Thenicolaibulow/decaVox/decaVox.kicad_sch

## KiCad design decaVox.kicad_sch (2022-06-22)

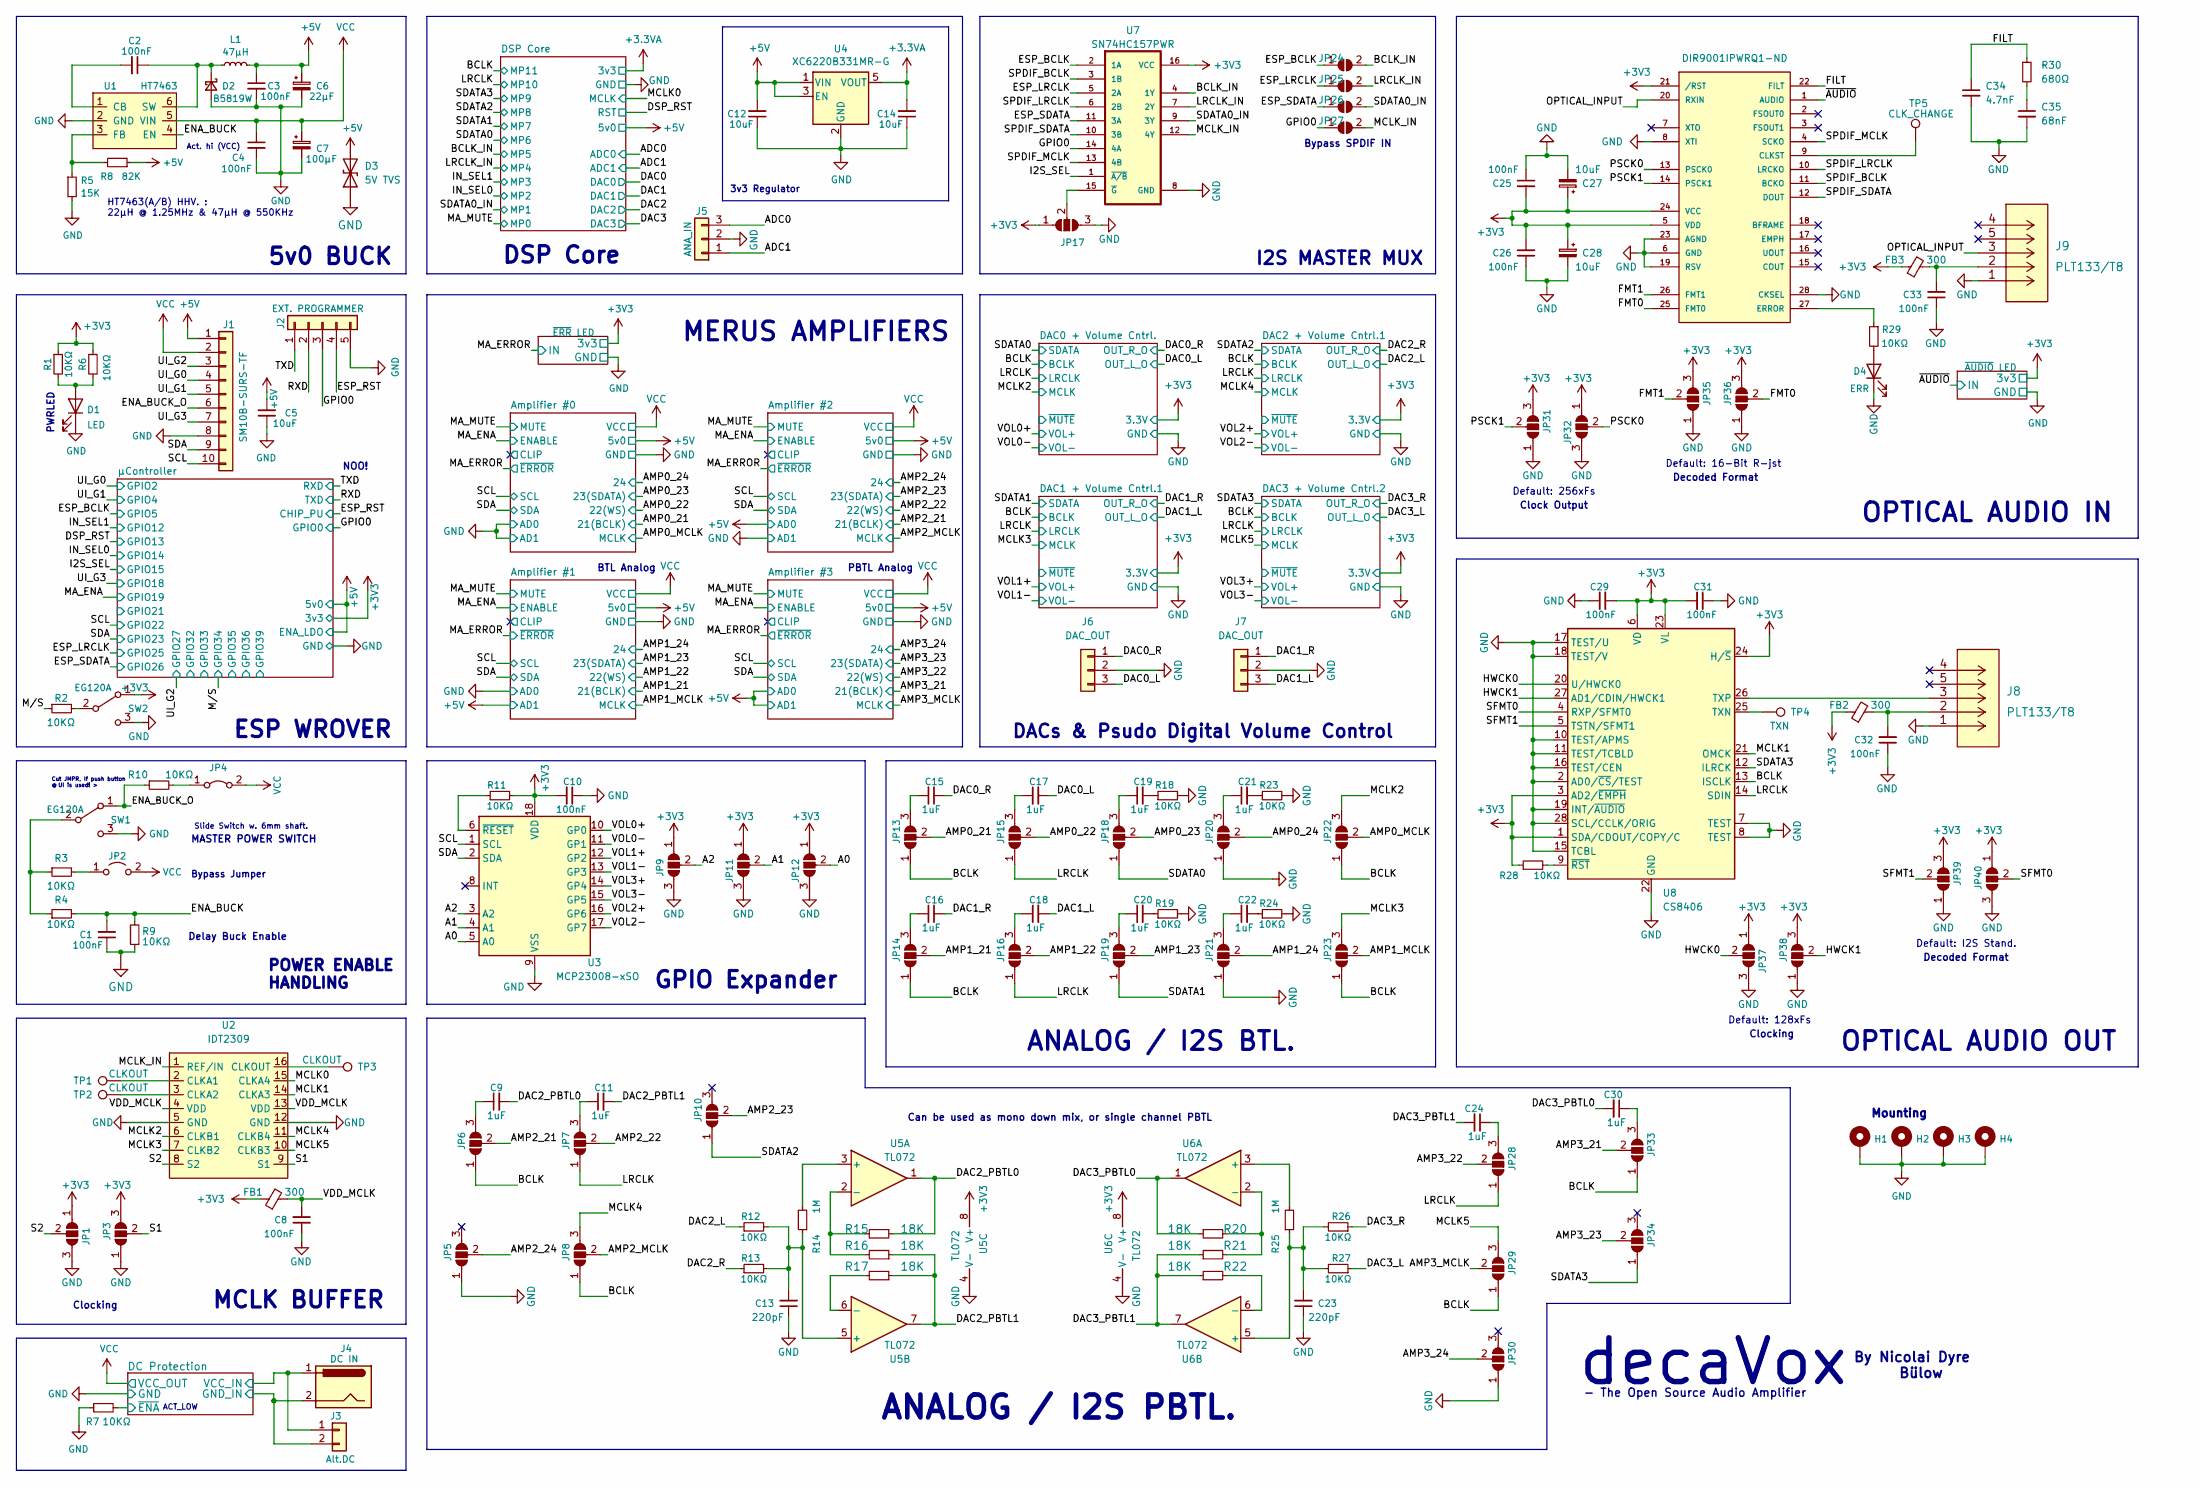
[picture p3: schematic decaVox.kicad_sch]

Parts:
C1, C2, C3, C4, C8, C10, C25, C26, C29, C31, C32, C33: 100nF; C_0603_1608Metric; LCSC C30926
C5: 10uF; C_0805_2012Metric; LCSC C162422
C6: 22µF; CP_Elec_4x5.4; LCSC C87865
C7: 100µF; CP_Elec_8x10; LCSC C38513
C9, C11, C15, C16, C17, C18, C19, C20, C21, C22, C24, C30: C_0603_1608Metric; LCSC C157684
C12, C14: 10uF; C_0603_1608Metric; LCSC C326057
C13, C23: C_0603_1608Metric; LCSC C302062
C27, C28: 10uF; CP_Elec_4x5.4; LCSC C213487
C34: 4.7nF; C_0603_1608Metric; LCSC C77057
C35: 68nF; C_0603_1608Metric; LCSC C354392
D1: LED; D_0603_1608Metric; LCSC C264445
D2: B5819W; D_SOD-123; LCSC C64885
D3: 5V TVS; D_SOD-323; LCSC C511254
D4: ERR; LED_0603_1608Metric; Digikey 160-1445-1-ND
FB1, FB2, FB3: 300; L_0603_1608Metric; LCSC C304316
H1, H2, H3, H4: MountingHole_Pad; MountingHole_3.2mm_M3_DIN965_Pad
J1: SM10B-SURS-TF; JST_SUR_SM10B-SURS-TF_1x10-1MP_P0.80mm_Horizontal; Digikey 455-2041-1-ND
J2: EXT. PROGRAMMER; PinHeader_1x05_P2.54mm_Vertical; LCSC C124379
J3: Alt.DC; JST_VH_B2PS-VH_1x02_P3.96mm_Horizontal
J4: DC IN; BarrelJack_CUI_PJ-063AH_Horizontal; Digikey CP-063AH-ND
J5: ANA_IN; PinHeader_1x03_P2.54mm_Vertical
J6, J7: DAC_OUT; PinHeader_1x03_P2.54mm_Vertical
J8, J9: PLT133/T8; PLT133&slash_T8; Digikey 1080-1505-ND
JP1, JP3, JP5, JP6, JP7, JP8, JP9, JP10, JP11, JP12, JP13, JP14, JP15, JP16, JP18, JP19, JP20, JP21, JP22, JP23, JP28, JP29, JP30, JP31, JP32, JP33, JP34, JP35, JP36, JP37, JP38, JP39, JP40: SolderJumper-3_P1.3mm_Bridged12_RoundedPad1.0x1.5mm
JP2: Jumper_2_Open; SolderJumper-2_P1.3mm_Open_RoundedPad1.0x1.5mm
JP4: Jumper_2_Bridged; SolderJumper-2_P1.3mm_Bridged_RoundedPad1.0x1.5mm
JP17: SolderJumper-3_P1.3mm_Open_RoundedPad1.0x1.5mm
JP24, JP25, JP26, JP27: SolderJumper_2_Open; SolderJumper-2_P1.3mm_Open_RoundedPad1.0x1.5mm
L1: 47µH; L_10.4x10.4_H4.8; LCSC C216171
R1, R2, R3, R4, R6, R7, R9, R10, R11, R12, R13, R18, R19, R23, R24, R26, R27, R28, R29: 10KΩ; R_0603_1608Metric; LCSC C98220
R5: 15K; R_0603_1608Metric; LCSC C328339
R8: 82K; R_0603_1608Metric; LCSC C23254
R14, R25: 1M; R_0603_1608Metric; LCSC C107698
R15, R16, R17, R20, R21, R22: 470O_08050805_R; R_0603_1608Metric; MFT_PART RTT05101JTP; LCSC C218379
R30: 680Ω; R_0603_1608Metric; LCSC C328372
SW1, SW2: EG120A; SLIDE-SWITCH; Digikey EG1917-ND
TP1, TP2, TP3: CLKOUT; TestPoint_Pad_D1.5mm
TP4: TXN; TestPoint_Pad_D1.5mm
TP5: CLK_CHANGE; TestPoint_Pad_D1.5mm
U1: HT7463; SOT-23-6; LCSC C95080
U2: IDT2309; SOIC-16_3.9x9.9mm_P1.27mm; Digikey 800-3296-5-ND
U3: MCP23008-xSO; SOIC-18W_7.5x11.6mm_P1.27mm
U4: XC6220B331MR-G; SOT-23-5; Digikey 893-1133-1-ND
U5: TL072; SO-8_3.9x4.9mm_P1.27mm
U6: TL072; SO-8_3.9x4.9mm_P1.27mm; Digikey 497-2200-1-ND
U7: SN74HC157PWR; TSSOP-16_4.4x5mm_P0.65mm; Digikey 296-29862-1-ND
U8: CS8406; TSSOP-28_4.4x9.7mm_P0.65mm; LCSC C11162
U9: DIR9001-Q1; TSSOP-28_4.4x9.7mm_P0.65mm; Digikey DIR9001IPWRQ1-ND

Connections:
+3.3VA: C14.2, U4.5 (VOUT)
+3V3: C10.2, C25.2, C26.2, C27.1, C28.1, C29.2, C31.2, FB1.1, FB2.1, FB3.1, JP1.1 (A), JP3.3 (B), JP9.1 (A), JP11.1 (A), JP12.1 (A), JP17.1 (A), JP31.3 (B), JP32.1 (A), JP35.3 (B), JP36.3 (B), JP37.1 (A), JP38.3 (B), JP39.3 (B), JP40.1 (A), R1.1, R6.1, R11.2, R28.1, SW2.1 (A), U3.18 (VDD), U5.8 (V+), U6.8 (V+), U7.16 (VCC), U8.1 (SDA/CDOUT/COPY/C), U8.3 (AD2/~EMPH), U8.6 (VD), U8.23 (VL), U8.24 (H/~S), U9.5 (VDD), U9.21 (/RST), U9.24 (VCC)
+5V: C3.1, C5.2, C6.1, C12.2, D3.2 (A2), J1.1, L1.2, R8.1, U4.1 (VIN), U4.3 (EN)
A0: JP12.2 (C), U3.5 (A0)
A1: JP11.2 (C), U3.4 (A1)
A2: JP9.2 (C), U3.3 (A2)
ADC0: J5.3
ADC1: J5.1
AMP0_21: JP13.2 (C)
AMP0_22: JP15.2 (C)
AMP0_23: JP18.2 (C)
AMP0_24: JP20.2 (C)
AMP0_MCLK: JP22.2 (C)
AMP1_21: JP14.2 (C)
AMP1_22: JP16.2 (C)
AMP1_23: JP19.2 (C)
AMP1_24: JP21.2 (C)
AMP1_MCLK: JP23.2 (C)
AMP2_21: JP6.2 (C)
AMP2_22: JP7.2 (C)
AMP2_23: JP10.2 (C)
AMP2_24: JP5.2 (C)
AMP2_MCLK: JP8.2 (C)
AMP3_21: JP33.2 (C)
AMP3_22: JP28.2 (C)
AMP3_23: JP34.2 (C)
AMP3_24: JP30.2 (C)
AMP3_MCLK: JP29.2 (C)
BCLK: JP6.1 (A), JP8.1 (A), JP13.1 (A), JP14.1 (A), JP22.1 (A), JP23.1 (A), JP29.1 (A), JP33.1 (A), U8.13 (ISCLK)
BCLK_IN: JP24.2 (B), U7.4 (1Y)
DAC0_L: C17.2, J6.3
DAC0_R: C15.2, J6.1
DAC1_L: C18.2, J7.3
DAC1_R: C16.2, J7.1
DAC2_L: R12.1
DAC2_PBTL0: C9.2, R15.1, U5.1
DAC2_PBTL1: C11.2, R16.1, R17.1, U5.7
DAC2_R: R13.1
DAC3_L: R27.1
DAC3_PBTL0: C30.2, R20.1, U6.1
DAC3_PBTL1: C24.2, R21.1, R22.1, U6.7
DAC3_R: R26.1
ENA_BUCK: C1.2, R4.2, R9.2, U1.4 (EN)
ENA_BUCK_O: J1.6, R10.1, SW1.1 (A)
ESP_BCLK: JP24.1 (A), U7.2 (1A)
ESP_LRCLK: JP25.1 (A), U7.5 (2A)
ESP_RST: J2.4
ESP_SDATA: JP26.1 (A), U7.11 (3A)
FILT: C34.1, R30.1, U9.22 (FILT)
FMT0: JP36.2 (C), U9.25 (FMT0)
FMT1: JP35.2 (C), U9.26 (FMT1)
GND: C1.1, C3.2, C4.2, C5.1, C6.2, C7.2, C8.1, C10.1, C12.1, C13.1, C14.1, C23.1, C25.1, C26.1, C27.2, C28.2, C29.1, C31.1, C32.1, C33.1, C34.2, C35.2, D1.1 (K), D2.2 (A), D3.1 (A1), D4.1 (K), H1.1, H2.1, H3.1, H4.1, J1.8, J2.5, J5.2, J6.2, J7.2, J8.1, J9.1, JP1.3 (B), JP3.1 (A), JP5.1 (A), JP9.3 (B), JP11.3 (B), JP12.3 (B), JP17.3 (B), JP20.1 (A), JP21.1 (A), JP30.1 (A), JP31.1 (A), JP32.3 (B), JP35.1 (A), JP36.1 (A), JP37.3 (B), JP38.1 (A), JP39.1 (A), JP40.3 (B), R5.2, R7.1, R9.1, R18.2, R19.2, R23.2, R24.2, SW1.3 (C), SW2.3 (C), U1.2 (GND), U2.5 (GND), U2.12 (GND), U3.9 (VSS), U4.2 (GND), U5.4 (V-), U6.4 (V-), U7.8 (GND), U8.2 (AD0/~CS/TEST), U8.7 (TEST), U8.8 (TEST), U8.10 (TEST/APMS), U8.11 (TEST/TCBLD), U8.15 (TCBL), U8.16 (TEST/CEN), U8.17 (TEST/U), U8.18 (TEST/V), U8.19 (INT/~AUDIO), U8.22 (GND), U8.28 (SCL/CCLK/ORIG), U9.6 (GND), U9.8 (XTI), U9.19 (RSV), U9.23 (AGND), U9.28 (CKSEL)
GND_IN: J3.2, J4.2
GPIO0: J2.3, JP27.1 (A), U7.14 (4A)
HWCK0: JP37.2 (C), U8.20 (U/HWCK0)
HWCK1: JP38.2 (C), U8.27 (AD1/CDIN/HWCK1)
I2S_SEL: U7.1 (~A/B)
LRCLK: JP7.1 (A), JP15.1 (A), JP16.1 (A), JP28.1 (A), U8.14 (SDIN)
LRCLK_IN: JP25.2 (B), U7.7 (2Y)
MCLK0: U2.15 (CLKA4)
MCLK1: U2.14 (CLKA3), U8.21 (OMCK)
MCLK2: JP22.3 (B), U2.6 (CLKB1)
MCLK3: JP23.3 (B), U2.7 (CLKB2)
MCLK4: JP8.3 (B), U2.11 (CLKB4)
MCLK5: JP29.3 (B), U2.10 (CLKB3)
MCLK_IN: JP27.2 (B), U2.1 (REF/IN), U7.12 (4Y)
M/S: R2.1
unnamed: C2.1, D2.1 (K), L1.1, U1.6 (SW)
unnamed: C2.2, U1.1 (CB)
unnamed: C9.1, JP6.3 (B)
unnamed: C11.1, JP7.3 (B)
unnamed: C13.2, R12.2, R13.2, R14.1, U5.5 (+)
unnamed: C15.1, JP13.3 (B)
unnamed: C16.1, JP14.3 (B)
unnamed: C17.1, JP15.3 (B)
unnamed: C18.1, JP16.3 (B)
unnamed: C19.1, JP18.3 (B)
unnamed: C19.2, R18.1
unnamed: C20.1, JP19.3 (B)
unnamed: C20.2, R19.1
unnamed: C21.1, JP20.3 (B)
unnamed: C21.2, R23.1
unnamed: C22.1, JP21.3 (B)
unnamed: C22.2, R24.1
unnamed: C23.2, R25.1, R26.2, R27.2, U6.5 (+)
unnamed: C24.1, JP28.3 (B)
unnamed: C30.1, JP33.3 (B)
unnamed: C32.2, FB2.2, J8.2
unnamed: C33.2, FB3.2, J9.2
unnamed: C35.1, R30.2
unnamed: D1.2 (A), R1.2, R6.2
unnamed: D4.2 (A), R29.2
unnamed: J8.3, U8.26 (TXP)
unnamed: JP2.1 (A), R3.2
unnamed: JP4.1 (A), R10.2
unnamed: JP17.2 (C), U7.15 (~G)
unnamed: R2.2, SW2.2 (B)
unnamed: R3.1, R4.1, SW1.2 (B)
unnamed: R5.1, R8.2, U1.3 (FB)
unnamed: R11.1, U3.6 (~RESET)
unnamed: R14.2, U5.3 (+)
unnamed: R15.2, R16.2, U5.2 (-)
unnamed: R17.2, U5.6 (-)
unnamed: R20.2, R21.2, U6.2 (-)
unnamed: R22.2, U6.6 (-)
unnamed: R25.2, U6.3 (+)
unnamed: R28.2, U8.9 (~RST)
unnamed: R29.1, U9.27 (ERROR)
unnamed: TP1.1, U2.2 (CLKA1)
unnamed: TP2.1, U2.3 (CLKA2)
unnamed: TP3.1, U2.16 (CLKOUT)
unnamed: TP4.1, U8.25 (TXN)
unnamed: TP5.1, U9.9 (CLKST)
OPTICAL_INPUT: J9.3, U9.20 (RXIN)
PSCK0: JP32.2 (C), U9.13 (PSCK0)
PSCK1: JP31.2 (C), U9.14 (PSCK1)
RXD: J2.2
S1: JP3.2 (C), U2.9 (S1)
S2: JP1.2 (C), U2.8 (S2)
SCL: J1.10, U3.1 (SCL)
SDA: J1.9, U3.2 (SDA)
SDATA0: JP18.1 (A)
SDATA0_IN: JP26.2 (B), U7.9 (3Y)
SDATA1: JP19.1 (A)
SDATA2: JP10.1 (A)
SDATA3: JP34.1 (A), U8.12 (ILRCK)
SFMT0: JP40.2 (C), U8.4 (RXP/SFMT0)
SFMT1: JP39.2 (C), U8.5 (TSTN/SFMT1)
SPDIF_BCLK: U7.3 (1B), U9.11 (BCKO)
SPDIF_LRCLK: U7.6 (2B), U9.10 (LRCKO)
SPDIF_MCLK: U7.13 (4B), U9.4 (SCKO)
SPDIF_SDATA: U7.10 (3B), U9.12 (DOUT)
TXD: J2.1
UI_G0: J1.4
UI_G1: J1.5
UI_G2: J1.3
UI_G3: J1.7
VCC: C4.1, C7.1, J1.2, JP2.2 (B), JP4.2 (B), U1.5 (VIN)
VCC_IN: J3.1, J4.1
VDD_MCLK: C8.2, FB1.2, U2.4 (VDD), U2.13 (VDD)
VOL0+: U3.10 (GP0)
VOL0-: U3.11 (GP1)
VOL1+: U3.12 (GP2)
VOL1-: U3.13 (GP3)
VOL2+: U3.16 (GP6)
VOL2-: U3.17 (GP7)
VOL3+: U3.14 (GP4)
VOL3-: U3.15 (GP5)
~AUDIO: U9.1 (AUDIO)
~ENA: R7.2

Notes on the sheet:
Bypass Jumper
Clocking
PBTL Analog
5v0 BUCK
PWRLED
ANALOG / I2S BTL.
POWER ENABLE HANDLING
Delay Buck Enable
DACs & Psudo Digital Volume Control
Cut JMPR, If push button @ UI is used! >
HT7463(A/B) HHV. : 22µH @ 1.25MHz & 47µH @ 550KHz
ESP WROVER
ANALOG / I2S PBTL.
Default: 128xFs
MCLK BUFFER
3v3 Regulator
Default: I2S Stand.
OPTICAL AUDIO IN
BTL Analog
Decoded Format
Act. hi (VCC)
I2S MASTER MUX
Default: 16-Bit R-jst
- The Open Source Audio Amplifier
MASTER POWER SWITCH
Mounting
decaVox
NOO!
ACT_LOW
Can be used as mono down mix, or single channel PBTL
By Nicolai Dyre Bülow
Default: 256xFs
Clock Output
GPIO Expander
Bypass SPDIF IN
OPTICAL AUDIO OUT
Slide Switch w. 6mm shaft.
DSP Core
MERUS AMPLIFIERS
