Thenicolaibulow/decaVox/Ext_Sch/ADAU1701.kicad_sch

## KiCad design Ext_Sch/ADAU1701.kicad_sch (2022-06-22)

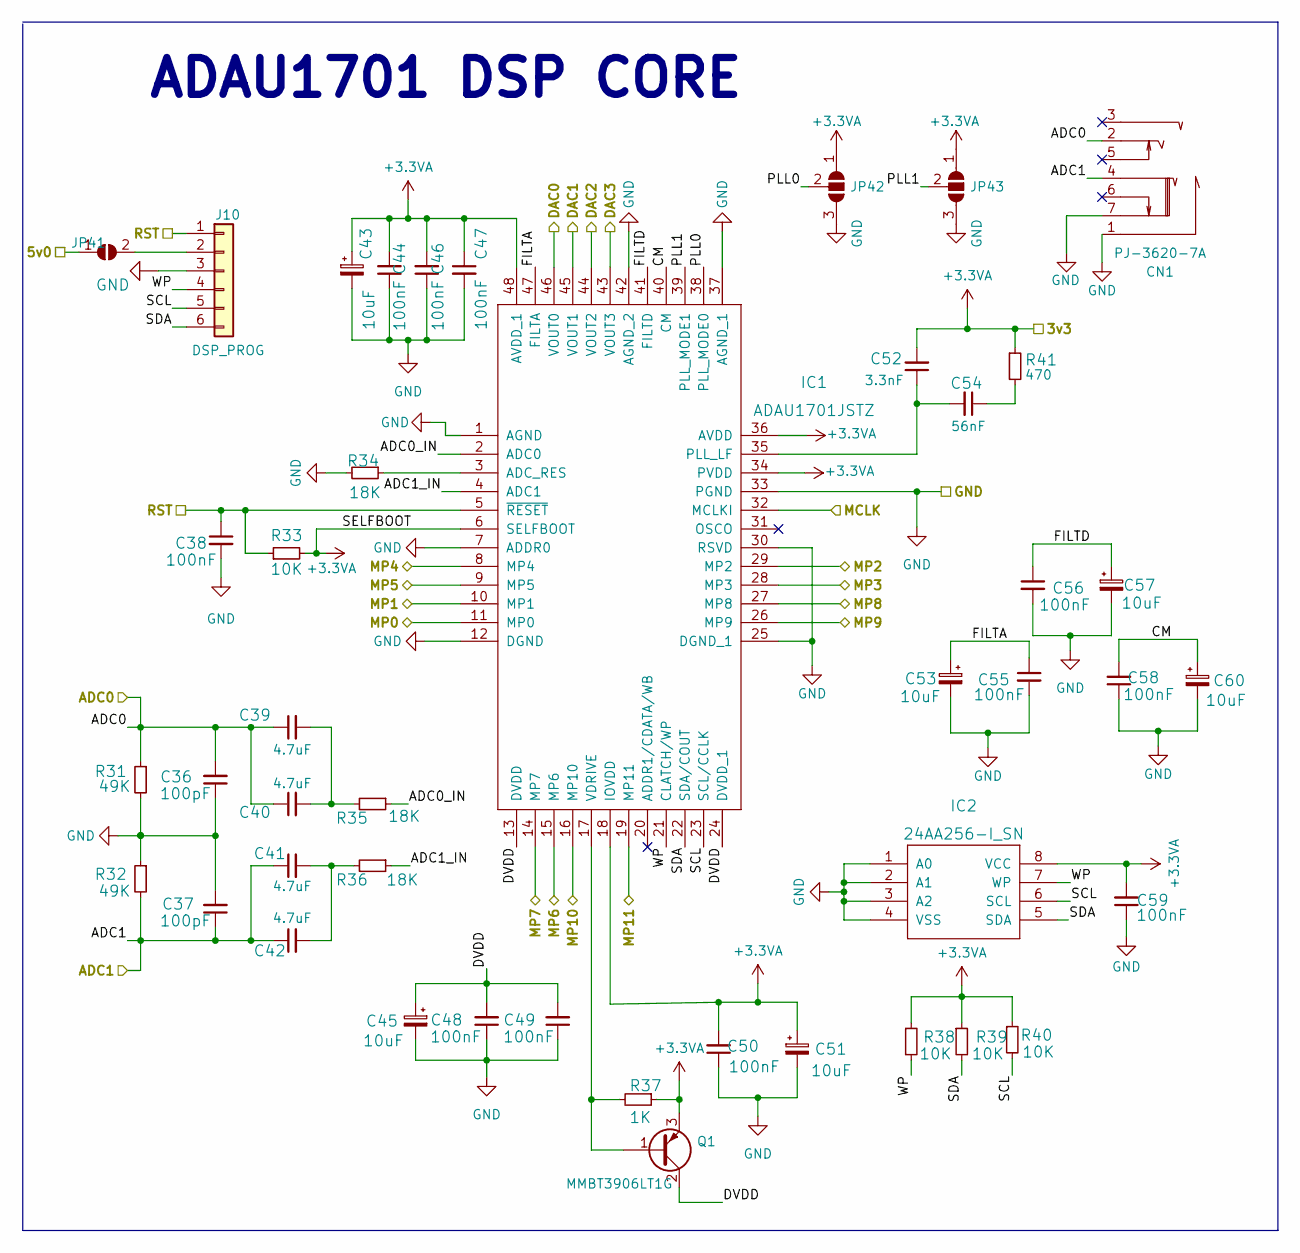
[picture p4: schematic ADAU1701.kicad_sch]

Parts:
C36, C37: 100NF_SMD_0805; C_0603_1608Metric; LCSC C82028
C38: 100NF_SMD_0805; C_0603_1608Metric; LCSC C128353
C39, C40, C41, C42: 4.7UF_CAP_SMD_06030603C; C_0603_1608Metric; LCSC C8032
C43, C45, C51, C53, C57, C60: TAJR106K006RNJ; CP_EIA-2012-12_Kemet-R; LCSC C132274
C44, C46, C47, C48, C49, C50, C55, C56, C58, C59: 100NF_SMD_0805; C_0603_1608Metric; LCSC C83054
C52: 3.3NF_CAP_SMD_08050805; C_0603_1608Metric; LCSC C92203
C54: 56NF_CAP_SMD_08050805; C_0603_1608Metric; LCSC C1780
CN1: PJ-3620-7A; AUDIO-TH_PJ-3620-7A; LCSC C879479
IC1: ADAU1701JSTZ; LQFP-48_7x7mm_P0.5mm
IC2: 24AA256-I_SN; SOIC-8_3.9x4.9mm_P1.27mm
J10: DSP_PROG; PinHeader_1x06_P2.54mm_Vertical
JP41: SolderJumper_2_Open; SolderJumper-2_P1.3mm_Open_RoundedPad1.0x1.5mm
JP42, JP43: SolderJumper_3_Open; SolderJumper-3_P1.3mm_Open_RoundedPad1.0x1.5mm
Q1: MMBT3906LT1G; SOT-23; LCSC C53444
R31, R32: 470O_08050805_R; R_0603_1608Metric; MFT_PART RTT05101JTP; LCSC C218595
R33, R38, R39, R40: 470O_08050805_R; R_0603_1608Metric; MFT_PART RTT05101JTP; LCSC C25612
R34, R35, R36: 470O_08050805_R; R_0603_1608Metric; MFT_PART RTT05101JTP; LCSC C218379
R37: 1K_0603; R_0603_1608Metric; LCSC C14676
R41: 470; R_0603_1608Metric; LCSC C114564

Connections:
5v0: JP41.1 (A)
+3.3VA: C43.1, C44.2, C46.2, C47.1, C50.2, C51.1, C52.2, C59.2, IC1.6 (SELFBOOT), IC1.18 (IOVDD), IC1.34 (PVDD), IC1.36 (AVDD), IC1.48 (AVDD_1), IC2.8 (VCC), JP42.1 (A), JP43.1 (A), Q1.3 (E), R33.2, R37.1, R38.1, R39.1, R40.1, R41.1
ADC0: C36.2, C39.1, C40.1, CN1.2, R31.1
ADC0_IN: IC1.2 (ADC0), R35.1
ADC1: C37.1, C41.1, C42.1, CN1.4, R32.2
ADC1_IN: IC1.4 (ADC1), R36.1
CM: C58.2, C60.1, IC1.40 (CM)
DAC0: IC1.46 (VOUT0)
DAC1: IC1.45 (VOUT1)
DAC2: IC1.44 (VOUT2)
DAC3: IC1.43 (VOUT3)
DVDD: C45.1, C48.2, C49.2, IC1.13 (DVDD), IC1.24 (DVDD_1), Q1.2 (C)
FILTA: C53.1, C55.1, IC1.47 (FILTA)
FILTD: C56.1, C57.1, IC1.41 (FILTD)
GND: C36.1, C37.2, C38.2, C43.2, C44.1, C45.2, C46.1, C47.2, C48.1, C49.1, C50.1, C51.2, C53.2, C55.2, C56.2, C57.2, C58.1, C59.1, C60.2, CN1.1, CN1.7, IC1.1 (AGND), IC1.7 (ADDR0), IC1.12 (DGND), IC1.25 (DGND_1), IC1.30 (RSVD), IC1.33 (PGND), IC1.37 (AGND_1), IC1.42 (AGND_2), IC2.1 (A0), IC2.2 (A1), IC2.3 (A2), IC2.4 (VSS), J10.3, JP42.3 (B), JP43.3 (B), R31.2, R32.1, R34.2
MCLK: IC1.32 (MCLKI)
MP0: IC1.11 (MP0)
MP1: IC1.10 (MP1)
MP2: IC1.29 (MP2)
MP3: IC1.28 (MP3)
MP4: IC1.8 (MP4)
MP5: IC1.9 (MP5)
MP6: IC1.15 (MP6)
MP7: IC1.14 (MP7)
MP8: IC1.27 (MP8)
MP9: IC1.26 (MP9)
MP10: IC1.16 (MP10)
MP11: IC1.19 (MP11)
unnamed: C39.2, C40.2, R35.2
unnamed: C41.2, C42.2, R36.2
unnamed: C52.1, C54.2, IC1.35 (PLL_LF)
unnamed: C54.1, R41.2
unnamed: IC1.3 (ADC_RES), R34.1
unnamed: IC1.17 (VDRIVE), Q1.1 (B), R37.2
unnamed: J10.2, JP41.2 (B)
PLL0: IC1.38 (PLL_MODE0), JP42.2 (C)
PLL1: IC1.39 (PLL_MODE1), JP43.2 (C)
RST: C38.1, IC1.5 (~RESET), J10.1, R33.1
SCL: IC1.23 (SCL/CCLK), IC2.6 (SCL), J10.5, R40.2
SDA: IC1.22 (SDA/COUT), IC2.5 (SDA), J10.6, R39.2
WP: IC1.21 (CLATCH/WP), IC2.7 (WP), J10.4, R38.2

Notes on the sheet:
ADAU1701 DSP CORE
