Thenicolaibulow/decaVox/Ext_Sch/DAC+Digipot.kicad_sch

## KiCad design Ext_Sch/DAC+Digipot.kicad_sch (2022-06-22)

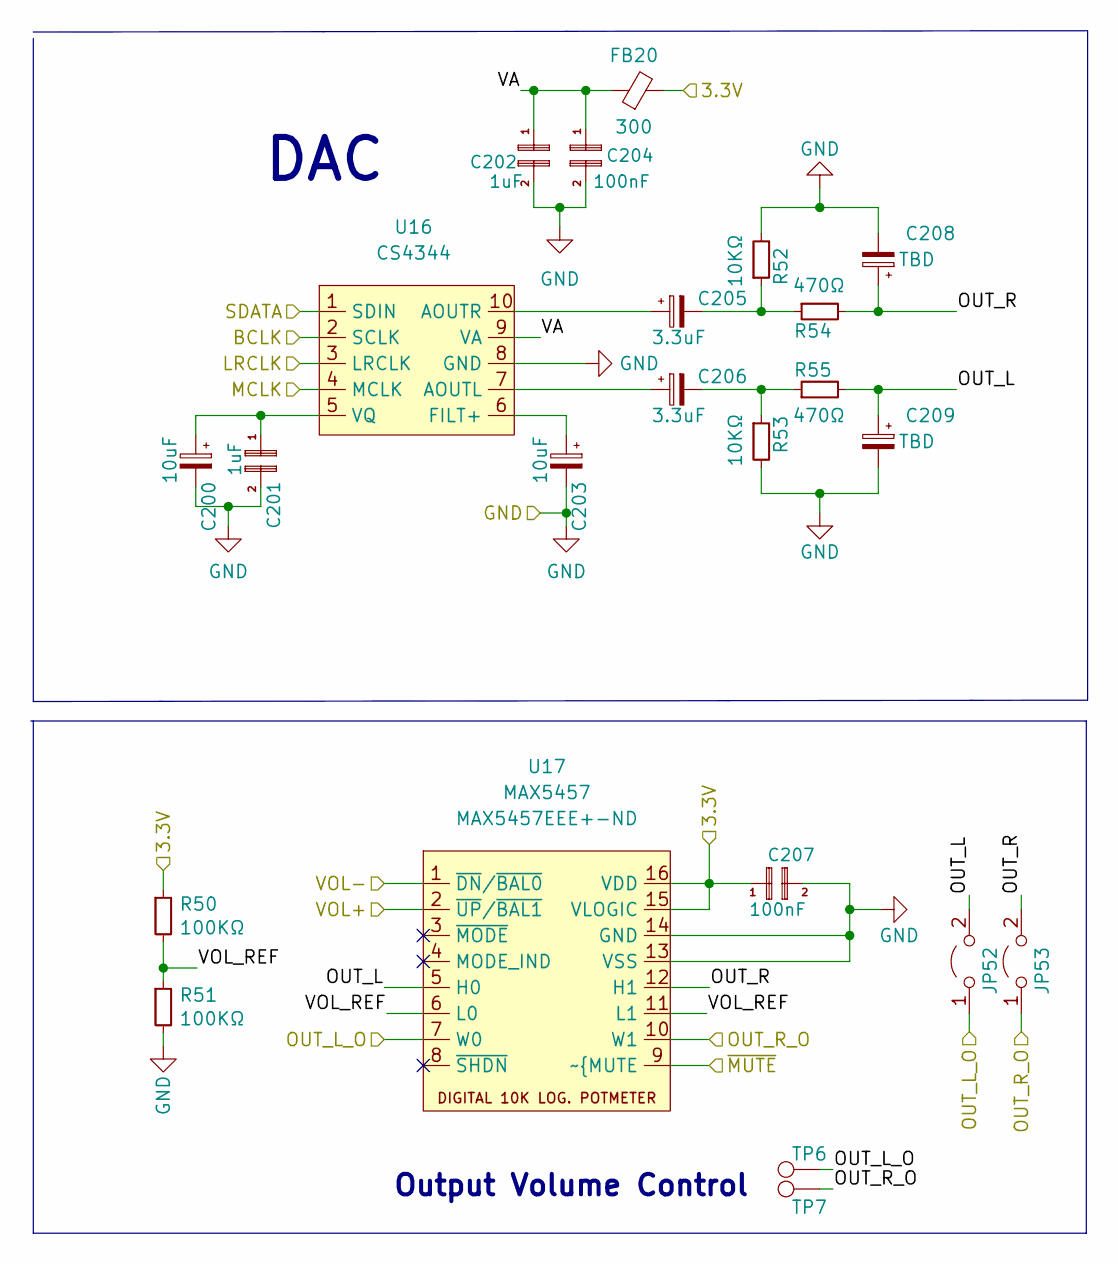
[picture p5: schematic DAC+Digipot.kicad_sch]

Parts:
C200, C203: 10uF; CP_Elec_4x5.4; LCSC C213487
C201, C202: 1uF; C_0603_1608Metric; LCSC C29936
C204, C207: 100nF; C_0603_1608Metric; LCSC C30926
C205, C206: 3.3uF; CP_Elec_3x5.3; LCSC C249528
C208, C209: TBD; CP_Elec_3x5.3
FB20: 300; L_0603_1608Metric; LCSC C304316
JP52, JP53: Jumper_2_Open; SolderJumper-2_P1.3mm_Open_RoundedPad1.0x1.5mm
R50, R51: 100KΩ; R_0603_1608Metric; LCSC C25803
R52, R53: 10KΩ; R_0603_1608Metric; LCSC C98220
R54, R55: 470Ω; R_0603_1608Metric; LCSC C269439
TP6, TP7: TestPoint; TestPoint_Pad_D1.5mm
U16: CS4344; TSSOP-10_3x3mm_P0.5mm; LCSC C8952
U17: MAX5457; SOP63P602X175-16N; Digikey MAX5457EEE+-ND

Connections:
3.3V: C207.1, FB20.2, R50.1, U17.15 (VLOGIC), U17.16 (VDD)
BCLK: U16.2 (SCLK)
GND: C200.2, C201.2, C202.2, C203.2, C204.2, C207.2, C208.2, C209.2, R51.2, R52.2, R53.2, U16.8 (GND), U17.13 (VSS), U17.14 (GND)
LRCLK: U16.3 (LRCLK)
MCLK: U16.4 (MCLK)
unnamed: C200.1, C201.1, U16.5 (VQ)
unnamed: C203.1, U16.6 (FILT+)
unnamed: C205.1, U16.10 (AOUTR)
unnamed: C205.2, R52.1, R54.1
unnamed: C206.1, U16.7 (AOUTL)
unnamed: C206.2, R53.1, R55.1
OUT_L: C209.1, JP52.2 (B), R55.2, U17.5 (H0)
OUT_L_O: JP52.1 (A), TP6.1, U17.7 (W0)
OUT_R: C208.1, JP53.2 (B), R54.2, U17.12 (H1)
OUT_R_O: JP53.1 (A), TP7.1, U17.10 (W1)
SDATA: U16.1 (SDIN)
VA: C202.1, C204.1, FB20.1, U16.9 (VA)
VOL+: U17.2 (~UP/~BAL1)
VOL-: U17.1 (~DN/~BAL0)
VOL_REF: R50.2, R51.1, U17.6 (L0), U17.11 (L1)
~MUTE: U17.9 (~{MUTE)

Notes on the sheet:
DAC
Output Volume Control
