Thenicolaibulow/decaVox/Ext_Sch/ESP32WROVER.kicad_sch

## KiCad design Ext_Sch/ESP32WROVER.kicad_sch (2022-06-22)

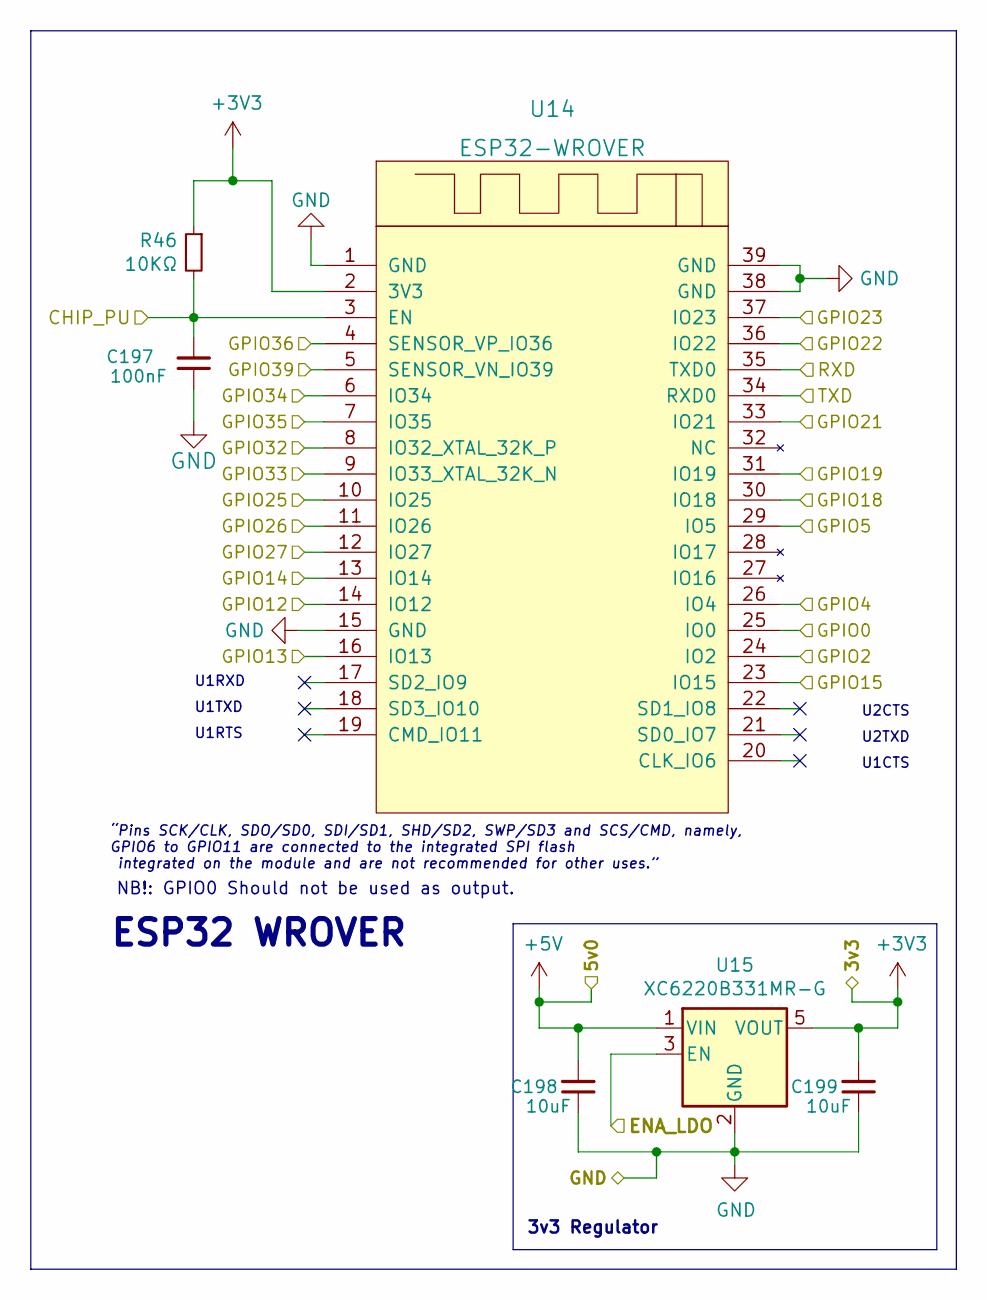
[picture p6: schematic ESP32WROVER.kicad_sch]

Parts:
C197: 100nF; C_0603_1608Metric; LCSC C30926
C198, C199: 10uF; C_0603_1608Metric; LCSC C326057
R46: 10KΩ; R_0603_1608Metric; LCSC C98220
U14: ESP32-WROVER; Digikey 1965-ESP32-WROVER-E-N16R8CT-ND
U15: XC6220B331MR-G; SOT-23-5; Digikey 893-1133-1-ND

Connections:
+3V3: C199.2, R46.1, U14.2 (3V3), U15.5 (VOUT)
+5V: C198.2, U15.1 (VIN)
CHIP_PU: C197.2, R46.2, U14.3 (EN)
ENA_LDO: U15.3 (EN)
GND: C197.1, C198.1, C199.1, U14.1 (GND), U14.15 (GND), U14.38 (GND), U14.39 (GND), U15.2 (GND)
GPIO0: U14.25 (IO0)
GPIO2: U14.24 (IO2)
GPIO4: U14.26 (IO4)
GPIO5: U14.29 (IO5)
GPIO12: U14.14 (IO12)
GPIO13: U14.16 (IO13)
GPIO14: U14.13 (IO14)
GPIO15: U14.23 (IO15)
GPIO18: U14.30 (IO18)
GPIO19: U14.31 (IO19)
GPIO21: U14.33 (IO21)
GPIO22: U14.36 (IO22)
GPIO23: U14.37 (IO23)
GPIO25: U14.10 (IO25)
GPIO26: U14.11 (IO26)
GPIO27: U14.12 (IO27)
GPIO32: U14.8 (IO32_XTAL_32K_P)
GPIO33: U14.9 (IO33_XTAL_32K_N)
GPIO34: U14.6 (IO34)
GPIO35: U14.7 (IO35)
GPIO36: U14.4 (SENSOR_VP_IO36)
GPIO39: U14.5 (SENSOR_VN_IO39)
RXD: U14.35 (TXD0)
TXD: U14.34 (RXD0)

Notes on the sheet:
U1RTS
U1TXD
3v3 Regulator
“Pins SCK/CLK, SDO/SD0, SDI/SD1, SHD/SD2, SWP/SD3 and SCS/CMD, namely, GPIO6 to GPIO11 are connected to the integrated SPI flash integrated on the module and are not recommended for other uses.”
U1CTS
U2CTS
NB!: GPIO0 Should not be used as output.
ESP32 WROVER
U2TXD
U1RXD
