Thenicolaibulow/decaVox/Ext_Sch/MA12070P.kicad_sch

## KiCad design Ext_Sch/MA12070P.kicad_sch (2022-06-22)

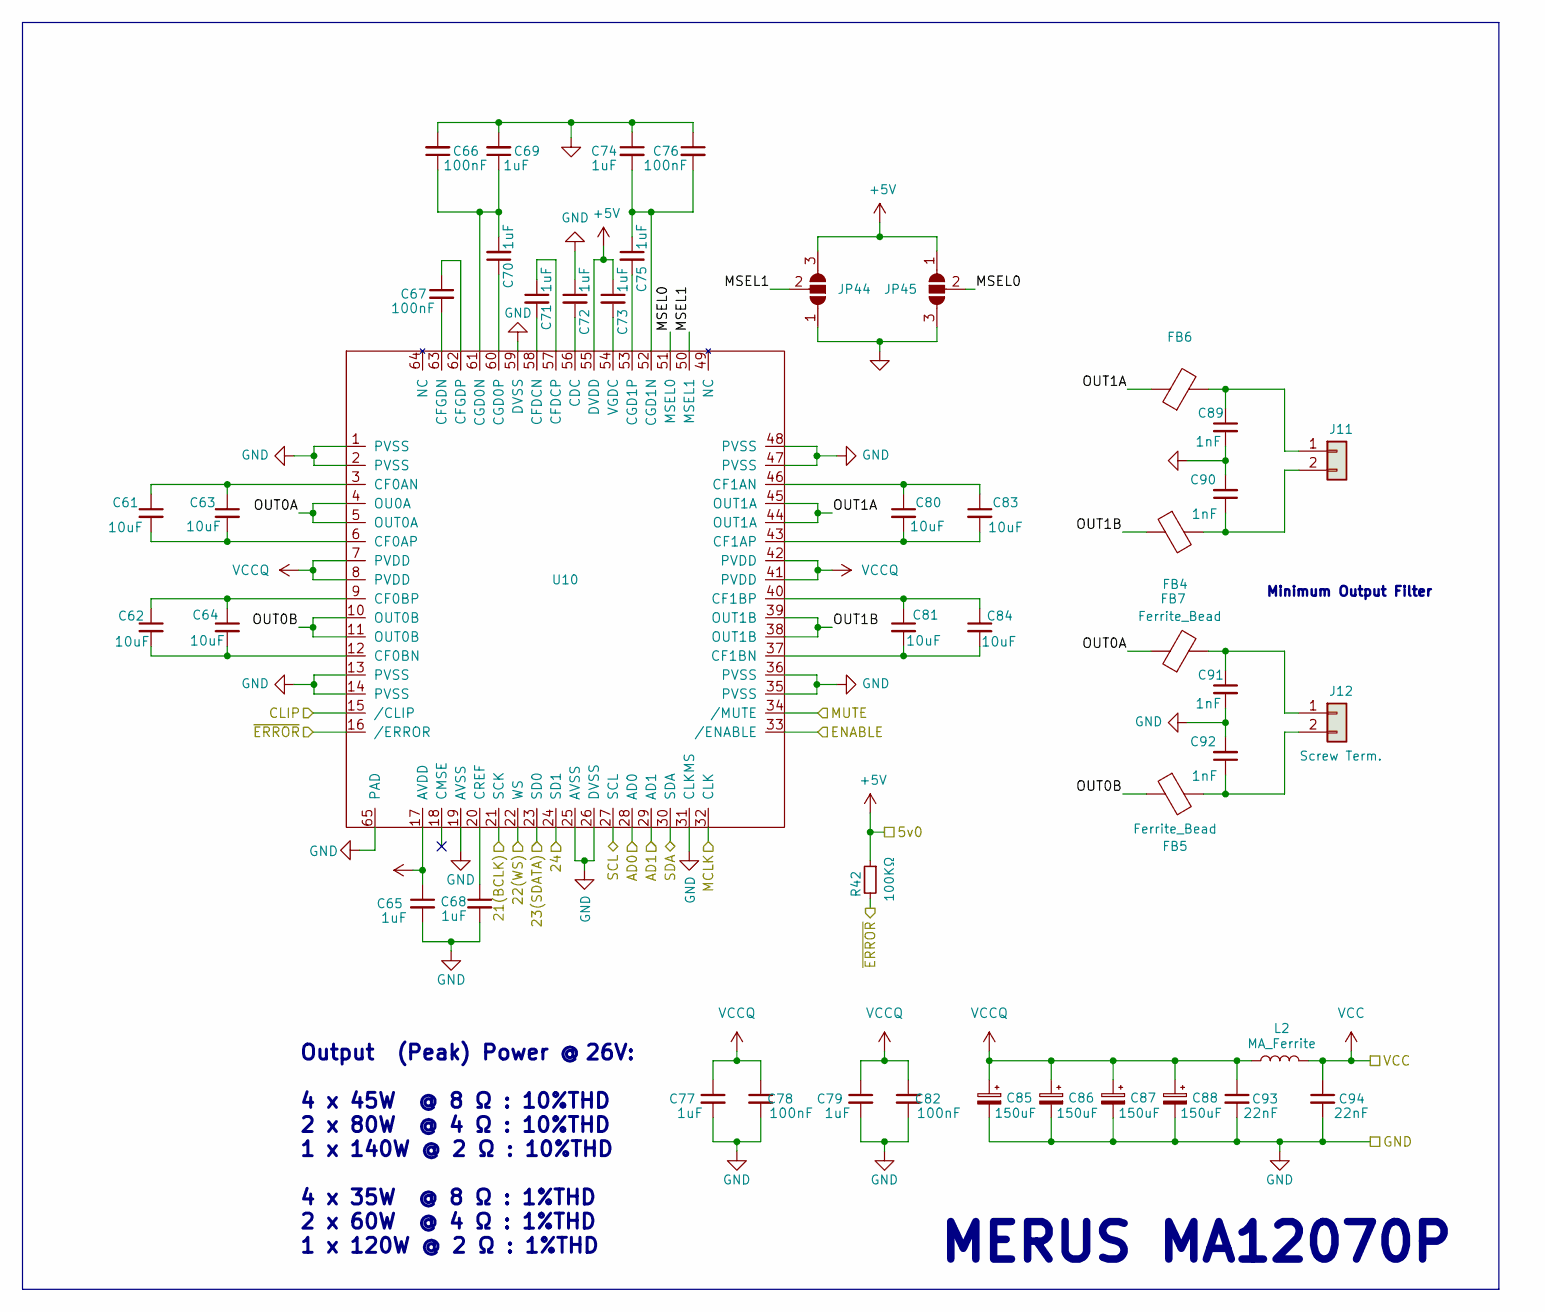
[picture p7: schematic MA12070P.kicad_sch]

Parts:
C61, C62, C63, C64: CAP_SMD_0805; C_0805_2012Metric; LCSC C162422
C65, C68, C70, C71, C72, C73, C75: C_0603_1608Metric; LCSC C157684
C66, C67, C76: C_0603_1608Metric; LCSC C30926
C69, C74: C_0805_2012Metric; LCSC C318694
C77, C79: CAP_SMD_0805; C_0805_2012Metric; LCSC C318694
C78, C82: CAP_SMD_0603; C_0603_1608Metric; LCSC C30926
C80, C81, C83, C84: C_0805_2012Metric; LCSC C162422
C85, C86, C87, C88: 150uF; CP_Elec_8x10; LCSC C38513
C89, C90: C_0603_1608Metric; LCSC C44369
C91, C92: CAP_SMD_0603; C_0603_1608Metric; LCSC C44369
C93: CAP_SMD_0603; C_0603_1608Metric; LCSC C21122
C94: C_0603_1608Metric; LCSC C21122
FB4, FB6: C_1206_3216Metric; Mouser 623-2512065007Y6
FB5, FB7: Ferrite_Bead; C_1206_3216Metric; Mouser 623-2512065007Y6
J11: Phoenix1989447; Digikey 277-16667-ND
J12: Screw Term.; Phoenix1989447; Digikey 277-16667-ND
JP44, JP45: SolderJumper-3_P1.3mm_Bridged12_RoundedPad1.0x1.5mm
L2: MA_Ferrite; Mouser 623-2743019447LF
R42: 100KΩ; R_0603_1608Metric; LCSC C25803
U10: QFN-64-1EP_9x9mm_P0.5mm_EP5.45x5.45mm_ThermalVias

Connections:
21(BCLK): U10.21 (SCK)
22(WS): U10.22 (WS)
23(SDATA): U10.23 (SD0)
24: U10.24 (SD1)
+5V: C73.1, JP44.3 (B), JP45.1 (A), R42.1, U10.55 (DVDD)
AD0: U10.28 (AD0)
AD1: U10.29 (AD1)
CLIP: U10.15 (/CLIP)
ENABLE: U10.33 (/ENABLE)
GND: C65.2, C68.2, C72.1, C77.2, C78.2, C79.2, C82.2, C85.2, C86.2, C87.2, C88.2, C91.2, C92.2, C93.2, C94.2, U10.1 (PVSS), U10.2 (PVSS), U10.13 (PVSS), U10.14 (PVSS), U10.19 (AVSS), U10.25 (AVSS), U10.26 (DVSS), U10.31 (CLKMS), U10.35 (PVSS), U10.36 (PVSS), U10.47 (PVSS), U10.48 (PVSS), U10.59 (DVSS), U10.65 (PAD)
MCLK: U10.32 (CLK)
MSEL0: JP45.2 (C), U10.51 (MSEL0)
MSEL1: JP44.2 (C), U10.50 (MSEL1)
MUTE: U10.34 (/MUTE)
unnamed: C61.1, C63.1, U10.3 (CF0AN)
unnamed: C61.2, C63.2, U10.6 (CF0AP)
unnamed: C62.1, C64.1, U10.9 (CF0BP)
unnamed: C62.2, C64.2, U10.12 (CF0BN)
unnamed: C66.1, C69.1, C70.2, U10.61 (CGD0N)
unnamed: C67.1, U10.62 (CFGDP)
unnamed: C67.2, U10.63 (CFGDN)
unnamed: C68.1, U10.20 (CREF)
unnamed: C70.1, U10.60 (CGD0P)
unnamed: C71.1, U10.57 (CFDCP)
unnamed: C71.2, U10.58 (CFDCN)
unnamed: C72.2, U10.56 (CDC)
unnamed: C73.2, U10.54 (VGDC)
unnamed: C74.2, C75.1, C76.2, U10.52 (CGD1N)
unnamed: C75.2, U10.53 (CGD1P)
unnamed: C80.1, C83.1, U10.46 (CF1AN)
unnamed: C80.2, C83.2, U10.43 (CF1AP)
unnamed: C81.1, C84.1, U10.40 (CF1BP)
unnamed: C81.2, C84.2, U10.37 (CF1BN)
unnamed: C89.1, FB6.2, J11.1
unnamed: C90.1, FB4.2, J11.2
unnamed: C91.1, FB7.2, J12.1
unnamed: C92.1, FB5.2, J12.2
OUT0A: FB7.1, U10.4 (OU0A), U10.5 (OUT0A)
OUT0B: FB5.1, U10.10 (OUT0B), U10.11 (OUT0B)
OUT1A: FB6.1, U10.44 (OUT1A), U10.45 (OUT1A)
OUT1B: FB4.1, U10.38 (OUT1B), U10.39 (OUT1B)
SCL: U10.27 (SCL)
SDA: U10.30 (SDA)
VCC: C94.1, L2.1
VCCQ: C77.1, C78.1, C79.1, C82.1, C85.1, C86.1, C87.1, C88.1, C93.1, L2.2, U10.7 (PVDD), U10.8 (PVDD), U10.41 (PVDD), U10.42 (PVDD)
~: C65.1, C66.2, C69.2, C74.1, C76.1, C89.2, C90.2, JP44.1 (A), JP45.3 (B), U10.17 (AVDD)
~ERROR: R42.2, U10.16 (/ERROR)

Notes on the sheet:
MERUS MA12070P
Output (Peak) Power @ 26V: 4 x 45W @ 8 Ω : 10%THD 2 x 80W @ 4 Ω : 10%THD 1 x 140W @ 2 Ω : 10%THD 4 x 35W @ 8 Ω : 1%THD 2 x 60W @ 4 Ω : 1%THD 1 x 120W @ 2 Ω : 1%THD
Minimum Output Filter
