Thenicolaibulow/decaVox/Ext_Sch/MEYERS_DC.kicad_sch

## KiCad design Ext_Sch/MEYERS_DC.kicad_sch (2022-06-22)

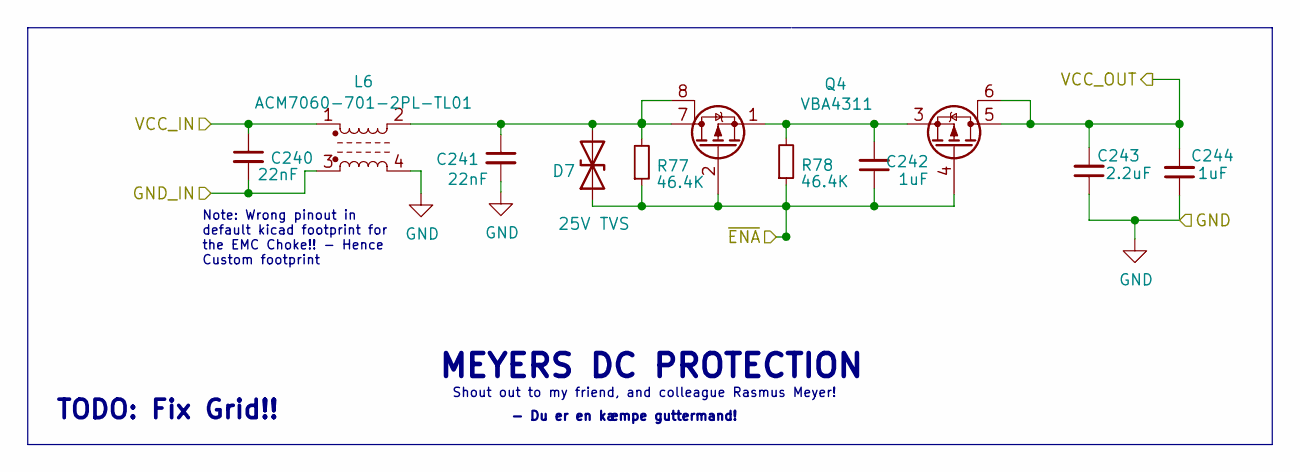
[picture p8: schematic MEYERS_DC.kicad_sch]

Parts:
C240: 22nF; C_0603_1608Metric; LCSC C21122
C241: 22nF; C_0603_1608Metric; Digikey C21122
C242, C244: 1uF; C_0805_2012Metric; Digikey C318694
C243: 2.2uF; C_0603_1608Metric; LCSC C968782
D7: 25V TVS; D_SMB; LCSC C113990
L6: ACM7060-701-2PL-TL01; LCSC C908568
Q4: VBA4311; SO-8_3.9x4.9mm_P1.27mm; LCSC C480935
R77, R78: 46.4K; R_0603_1608Metric; LCSC C321921

Connections:
GND: C241.2, C243.1, C244.1, L6.4
GND_IN: C240.2, L6.3
unnamed: C241.1, D7.2 (A2), L6.2, Q4.7 (D), Q4.8 (D), R77.2
unnamed: C242.2, Q4.1 (S), Q4.3 (S), R78.2
VCC_IN: C240.1, L6.1
VCC_OUT: C243.2, C244.2, Q4.5 (D), Q4.6 (D)
~ENA: C242.1, D7.1 (A1), Q4.2 (G), Q4.4 (G), R77.1, R78.1

Notes on the sheet:
Note: Wrong pinout in default kicad footprint for the EMC Choke!! - Hence Custom footprint
Shout out to my friend, and colleague Rasmus Meyer!
- Du er en kæmpe guttermand!
MEYERS DC PROTECTION
TODO: Fix Grid!!
