Thenicolaibulow/decaVox/Ext_Sch/MOS_LED_ACT_LOW.kicad_sch

## KiCad design Ext_Sch/MOS_LED_ACT_LOW.kicad_sch (2022-06-22)

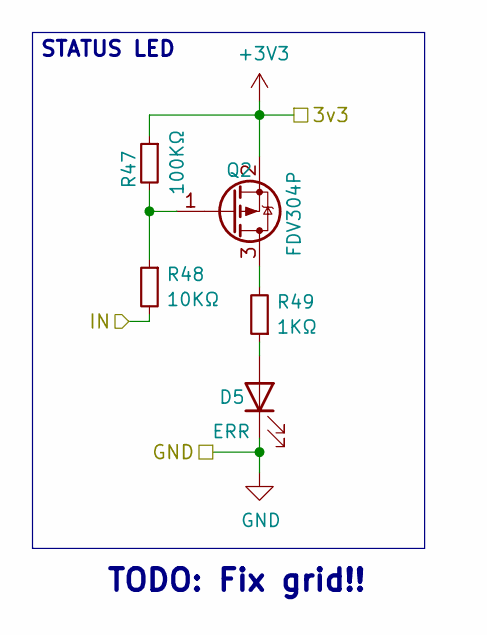
[picture p9: schematic MOS_LED_ACT_LOW.kicad_sch]

Parts:
D5: ERR; LED_0603_1608Metric; Digikey 160-1445-1-ND
Q2: FDV304P; SOT-23W; LCSC C709971
R47: 100KΩ; R_0603_1608Metric; LCSC C25803
R48: 10KΩ; R_0603_1608Metric; LCSC C25612
R49: 1KΩ; R_0603_1608Metric; LCSC C14676

Connections:
+3V3: Q2.2 (S), R47.1
GND: D5.1 (K)
IN: R48.2
unnamed: D5.2 (A), R49.1
unnamed: Q2.1 (G), R47.2, R48.1
unnamed: Q2.3 (D), R49.2

Notes on the sheet:
TODO: Fix grid!!
STATUS LED
